vedpatel-learner/riscv-sv32-software-managed-tlb/docs/figures/miss_penalty.pdf

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

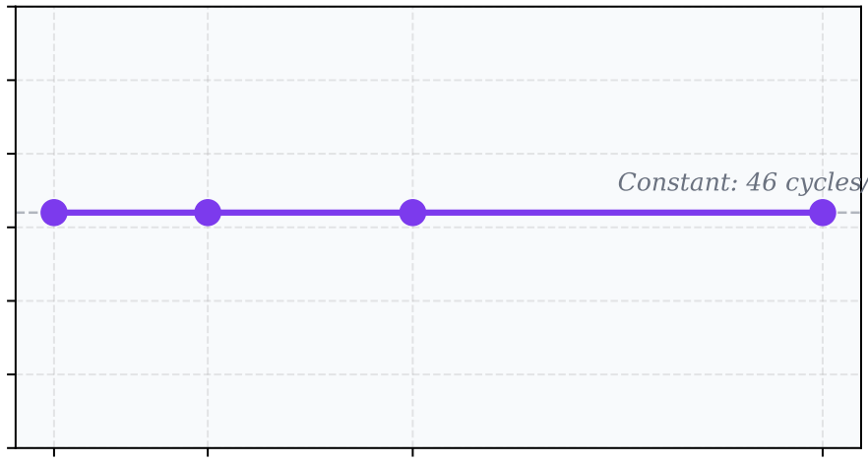
[picture p8: figure]
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
