vedpatel-learner/riscv-sv32-software-managed-tlb/docs/figures/emat.png

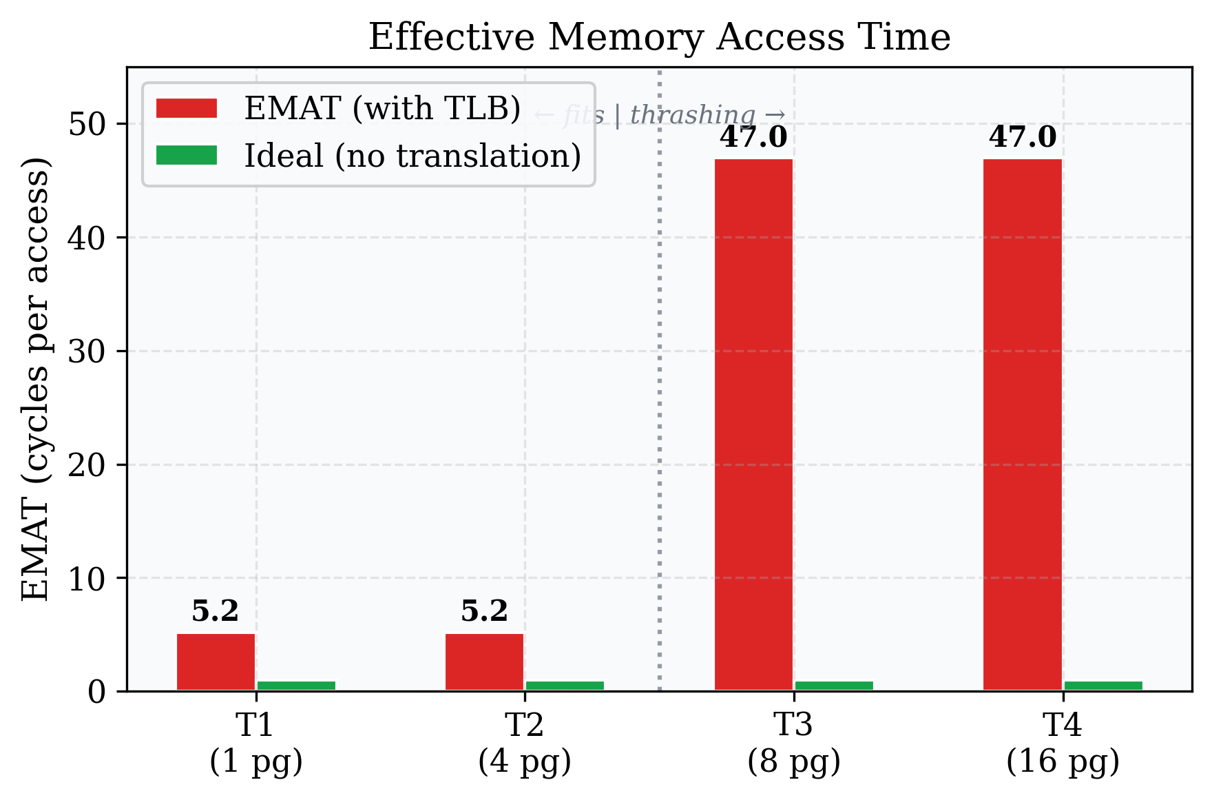
docs/figures/emat.png
