vedpatel-learner/riscv-sv32-software-managed-tlb/docs/figures/hit_rate.png

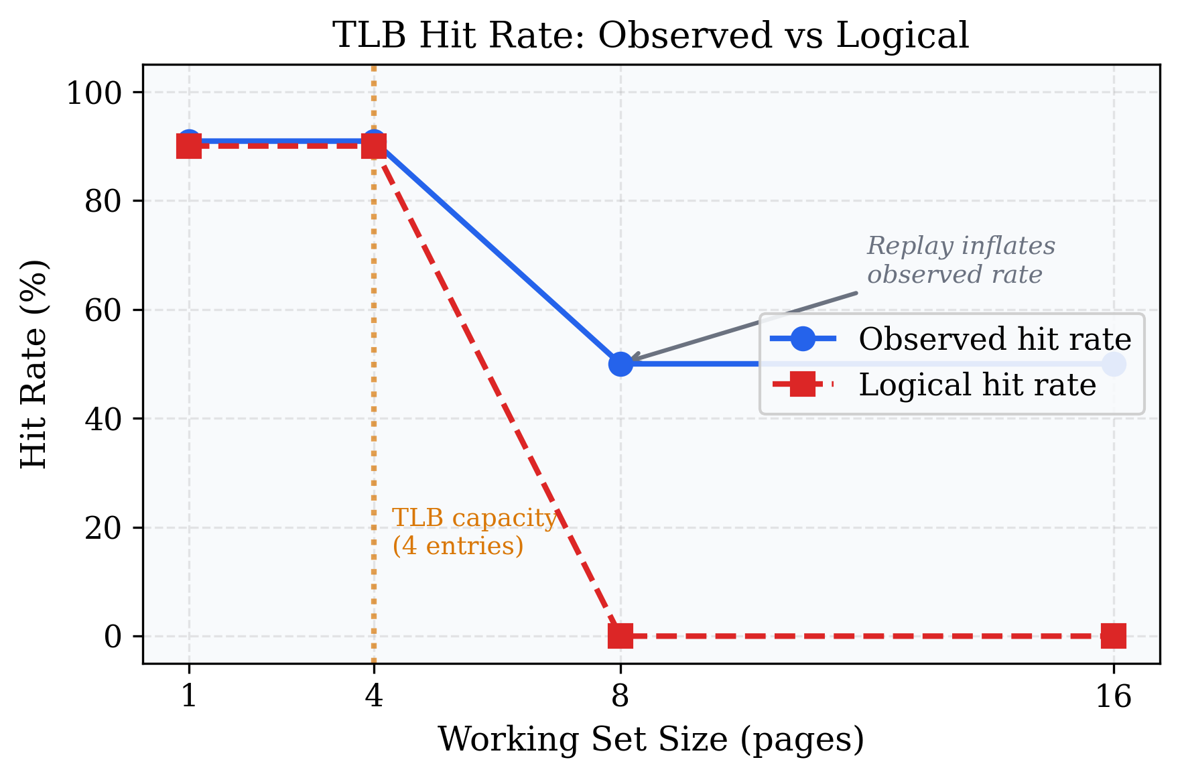
docs/figures/hit_rate.png
