vedpatel-learner/riscv-sv32-software-managed-tlb/docs/figures/cycles_comparison.pdf

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

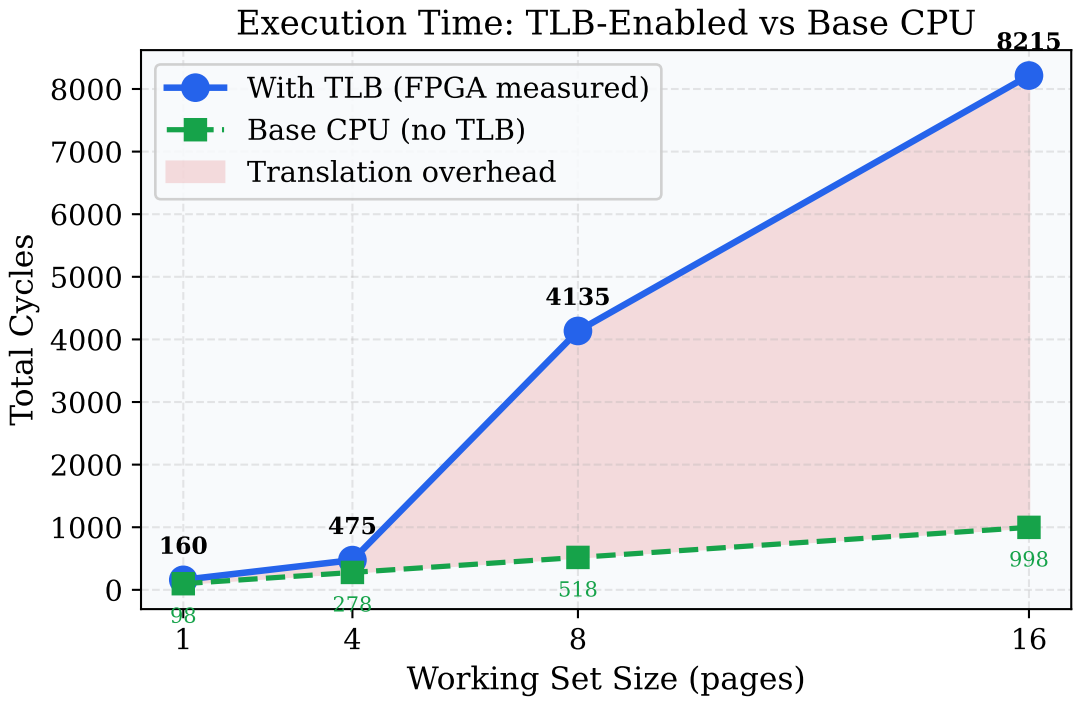
[picture p11: page 1]
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
