vedpatel-learner/riscv-sv32-software-managed-tlb/rtl/uart_tx.v

// ============================================================================
//  uart_tx.v — UART Transmitter (8N1)
//  Parameterized clock frequency and baud rate
// ============================================================================
module uart_tx #(
    parameter CLK_FREQ  = 125_000_000,
    parameter BAUD_RATE = 115_200
)(
    input  wire       clk,
    input  wire       rst,        // active-low
    input  wire       tx_start,   // pulse to begin transmission
    input  wire [7:0] tx_data,    // byte to send
    output reg        tx,         // serial output (idle high)
    output wire       tx_busy     // high while transmitting
);

    localparam CLKS_PER_BIT = CLK_FREQ / BAUD_RATE;

    localparam [1:0] S_IDLE  = 2'd0,
                     S_START = 2'd1,
                     S_DATA  = 2'd2,
                     S_STOP  = 2'd3;

    reg [1:0]  state;
    reg [15:0] clk_cnt;
    reg [2:0]  bit_idx;
    reg [7:0]  data_reg;

    assign tx_busy = (state != S_IDLE);

    always @(posedge clk or negedge rst) begin
        if (!rst) begin
            state    <= S_IDLE;
            tx       <= 1'b1;
            clk_cnt  <= 16'd0;
            bit_idx  <= 3'd0;
            data_reg <= 8'd0;
        end else begin
            case (state)
                S_IDLE: begin
                    tx      <= 1'b1;
                    clk_cnt <= 16'd0;
                    bit_idx <= 3'd0;
                    if (tx_start) begin
                        data_reg <= tx_data;
                        state    <= S_START;
                    end
                end

                S_START: begin
                    tx <= 1'b0;  // start bit
                    if (clk_cnt == CLKS_PER_BIT - 1) begin
                        clk_cnt <= 16'd0;
                        state   <= S_DATA;
                    end else begin
                        clk_cnt <= clk_cnt + 16'd1;
                    end
                end

                S_DATA: begin
                    tx <= data_reg[bit_idx];  // LSB first
                    if (clk_cnt == CLKS_PER_BIT - 1) begin
                        clk_cnt <= 16'd0;
                        if (bit_idx == 3'd7) begin
                            state <= S_STOP;
                        end else begin
                            bit_idx <= bit_idx + 3'd1;
                        end
                    end else begin
                        clk_cnt <= clk_cnt + 16'd1;
                    end
                end

                S_STOP: begin
                    tx <= 1'b1;  // stop bit
                    if (clk_cnt == CLKS_PER_BIT - 1) begin
                        clk_cnt <= 16'd0;
                        state   <= S_IDLE;
                    end else begin
                        clk_cnt <= clk_cnt + 16'd1;
                    end
                end

                default: state <= S_IDLE;
            endcase
        end
    end

endmodule
